Nowis75/atmegaplatform/(list of files, drawings)

Other design files:
docs/fritzing/02-a-led.fzz
docs/fritzing/02-d-logic-gate.fzz
docs/fritzing/04-eeprom.fzz
docs/fritzing/05-interrupts.fzz
docs/fritzing/06-i2c-bme280.fzz
docs/fritzing/07-analog-ntc.fzz
