Nowis75/atmegaplatform/hardware/kicad/ATMega-platform.kicad_pcb

## KiCad design hardware/kicad/ATMega-platform.kicad_pcb (2026-11-09)

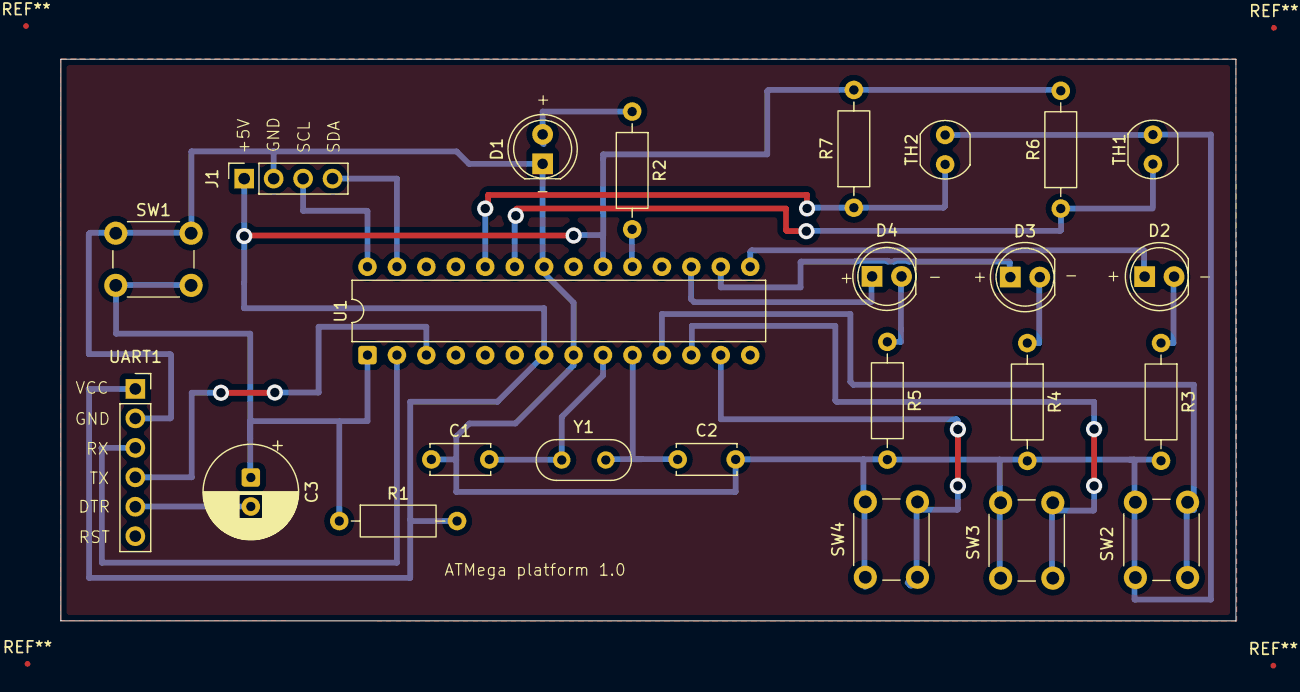
[picture p1: board ATMega-platform.kicad_pcb from above]

Board: 2 copper layers, 101.4 x 48.5 mm, 24 parts (0 on the bottom side), 23 nets.

Parts:
C1, C2: 22pF; C_Disc_D5.0mm_W2.5mm_P5.00mm
C3: 1uF; CP_Radial_D8.0mm_P2.50mm
D1, D2, D3, D4: LED; LED_D5.0mm
J1: BME280_socket; PinSocket_1x04_P2.54mm_Vertical
R1, R6, R7: 10k; R_Axial_DIN0207_L6.3mm_D2.5mm_P10.16mm_Horizontal
R2, R3, R4, R5: 220; R_Axial_DIN0207_L6.3mm_D2.5mm_P10.16mm_Horizontal
SW1: SW_Push; SW_PUSH_6mm
SW2, SW3, SW4: SW_DIP_x02; SW_PUSH_6mm
TH1, TH2: Thermistor; R_LDR_4.9x4.2mm_P2.54mm_Vertical
U1: ATmega328-P; DIP-28_W7.62mm
UART1: UART_Socket; PinSocket_1x06_P2.54mm_Vertical
Y1: Crystal; Crystal_HC52-6mm_Vertical

Connections:
A0: R6.1, TH1.1, U1.23 (PC0)
A1: R7.1, TH2.1, U1.24 (PC1)
D5: SW2.2, U1.11 (PD5)
D6: SW3.2, U1.12 (PD6)
D7: SW4.2, U1.13 (PD7)
D9: D2.1 (K), U1.15 (PB1)
D10: D3.1 (K), U1.16 (PB2)
D11: D4.1 (K), U1.17 (PB3)
D13: R2.2, U1.19 (PB5)
DTR: C3.2, UART1.5
GND: C1.2, C2.2, D1.1 (K), J1.2, R3.2, R4.2, R5.2, SW1.1, SW2.1, SW3.1, SW4.1, TH1.2, TH2.2, U1.8 (GND), U1.22 (GND), UART1.2
unnamed: D1.2 (A), R2.1
unnamed: D2.2 (A), R3.1
unnamed: D3.2 (A), R4.1
unnamed: D4.2 (A), R5.1
RST: C3.1, R1.1, SW1.2, U1.1 (~RESET/PC6)
RX: U1.2 (PD0), UART1.3
SCL: J1.3, U1.28 (PC5)
SDA: J1.4, U1.27 (PC4)
TX: U1.3 (PD1), UART1.4
VCC: J1.1, R1.2, R6.2, R7.2, U1.7 (VCC), U1.20 (AVCC), UART1.1
XTAL1: C1.1, U1.9 (XTAL1/PB6), Y1.1
XTAL2: C2.1, U1.10 (XTAL2/PB7), Y1.2
