Nowis75/atmegaplatform/(commit log)

2026-11-09 Initial release: firmware examples for the ATmega328P socket-based teaching platform
    Claude-Session: https://claude.ai/code/session_01SuRm2dBkJGTU8WkzJ9nNXx
    [02-a-led.fzz, 02-d-logic-gate.fzz, 04-eeprom.fzz, 05-interrupts.fzz, 06-i2c-bme280.fzz, 07-analog-ntc.fzz]
2026-11-09 Add KiCad schematic/PCB and BOM; LED series resistors 220 Ohm
    - hardware/kicad: project, schematic and two-layer PCB of the carrier board
    - R2-R5 (LED series resistors) changed from 10k to 220 Ohm
    - hardware/bom.csv with component roles and footprints
    - README: pin map updated from the PCB netlist (D13 LED, UART pinout,
    DTR auto-reset, switches to GND)
    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
    [ATMega-platform.kicad_pcb, ATMega-platform.kicad_sch, bom.csv]
2026-11-09 Add anonymized questionnaire data and analysis scripts
    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
    [questionnaire_responses.csv]
2026-11-09 Update schematic (LED circuits redrawn, R2 220 Ohm); hardware notes
    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
    [ATMega-platform.kicad_sch]
2026-11-09 Schematic rev 1.1: SW_Push buttons, GND labels and R2 fixed
    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
    [ATMega-platform.kicad_sch]
